AdnanCinisi/Pulse-Oximeter/AFE/Results/BodePlot.jpg

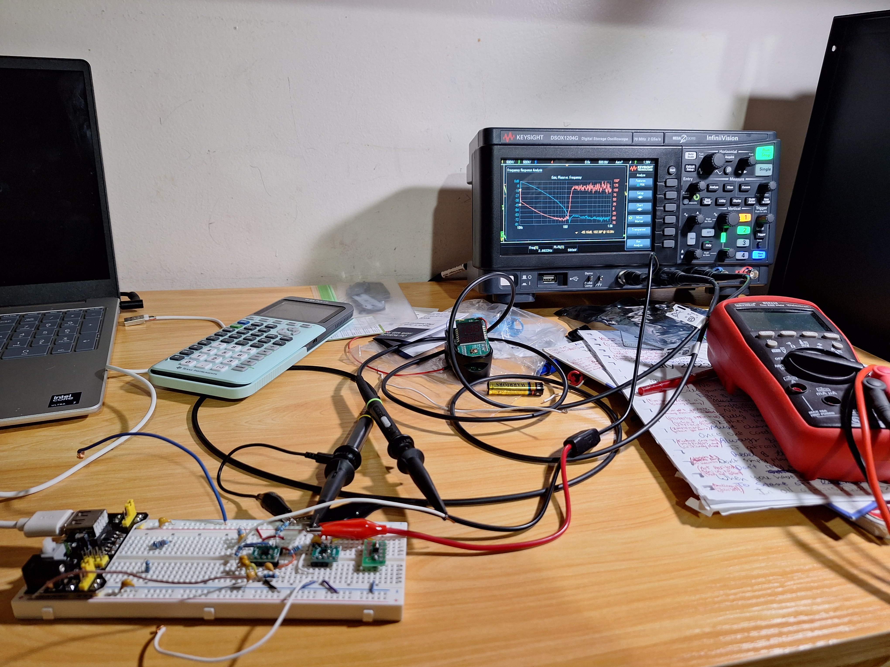
AFE/Results/BodePlot.jpg
