AdnanCinisi/Pulse-Oximeter/AFE/Results/PR_Capture.jpg

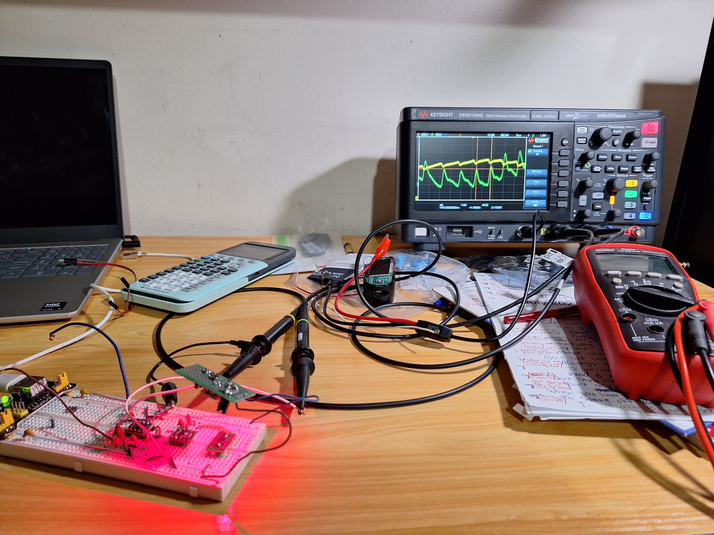
AFE/Results/PR_Capture.jpg
