AdnanCinisi/Pulse-Oximeter/README.md

# Pulse-Oximeter
Collection of Documentation created for designing portable IoT Pulse Oximeter

Master Spreadsheet: https://docs.google.com/spreadsheets/d/1wvMzt9Z9Bt-hhxMeCyEJHelC8ms1J6ctH8SdlQohNYU/edit?usp=sharing
