AdnanCinisi/Pulse-Oximeter/MCU/README.md

Source code, EVB prototype code, and other digital related items
