AdnanCinisi/Pulse-Oximeter/AltiumDocs/README.md

Altium Schematics & PCB files
Link to most recent Version: https://adnan-cinisi.365.altium.com/designs/D5FFC35A-2DEE-41BC-8201-609277D95F90
