AdnanCinisi/Pulse-Oximeter/AFE/README.md

Analog Front End Simulations & prototype Results
