AdnanCinisi/Pulse-Oximeter/Power/README.md

Simulations & other Docs for Power

Went with simple Arch: 
Batteries -> Boost -> LDO -> AFE+MCU+Screen
