AdnanCinisi/Pulse-Oximeter/AFE/SIMs/OPA320_Test.asc

U1: OPAx320-Q1
V1: voltage; SINE(2.5 2.5 1k)
V2: voltage; 6V
Named nets: Vsup, 0
.tran 0 5m 0 10u
