AdnanCinisi/Pulse-Oximeter/Power/TPS61040.asc

C1: cap; 4.7µ
C2: cap; 1µ
C3: cap; 20p
D1: diode
I1: current; PULSE(0 200m 1.5u .1u .1u 1)
L1: ind; 2.2µ
R1: res; 200k
R2: res; 380k
R3: res; 0
U2: TPS61040_TRANS
V1: voltage; PULSE(0 3 1us .01u .1u 1); Rser=10m
Named nets: 0, Vin, Vout
Vout = 3.6V
Check Excel for formulas
 
Gets loaded past ~100mA. Can this drive screen?
Reverse Recovery time of diode is faster than Tsw
AvgIout = 500mA
Pd = If * Vf = 500mA*390mV ~ 200mW
Do I need 30V diode?
.tran 0 200u 0 .1u
