AdnanCinisi/Pulse-Oximeter/AFE/SIMs/Sallen-Key LPF.asc

C1: cap; 1ľ
C2: cap; 3.9ľ
C3: cap; 1ľ
C4: cap; 1ľ
C5: cap; 1ľ
R1: res; 10k
R2: res; 200k
R3: res; 10k
R4: res; 13k
R5: res; 13k
R6: res; 1k
U1: OPAx320-Q1
U2: OPAx320-Q1
U3: OPAx320-Q1
V1: voltage; ""; AC 1
V2: voltage; SINE(0 1 .5)
V3: voltage; 1
V4: voltage; SINE(0 1 .5); AC 1
V5: voltage; SINE(0 1 .5)
V6: voltage; 2.5
V7: voltage; -2.5
V8: voltage; ""; AC 1
V9: voltage; SINE(0 1 .5)
Named nets: 0, 2v5, -2v5
IGNORE: Want Fc = 0.25Hz b/c 0.5Hz is min pulse freq
.ac dec 100 .01 100
.tran 0 5 0 1m
Even though my application has different supplies for OpAmp, 
with AC simulation, cannot set DC offset so Amp cannot have single supply
New Req: Fc = 10Hz
