AdnanCinisi/Pulse-Oximeter/AFE/SIMs/HPF.asc

C1: cap; 1ľ
C2: cap; 10ľ
C3: cap; 33n
C4: cap; 1ľ
C5: cap; 1ľ
R1: res; 820k
R2: res; 1Meg
R3: res; 240k
R4: res; 10k
R5: res; 10k
R6: res; 1k
R7: res; 82k
R8: res; 1k
R9: res; 410k
U1: OPAx320-Q1
U2: OPAx320-Q1
U3: OPAx320-Q1
V1: voltage; ""; AC 1
V2: voltage; SINE(0 1 .5)
V3: voltage; 1
V4: voltage; ""; AC 1
V5: voltage; SINE(0 1 .5)
V6: voltage; 2.5
V7: voltage; -2.5
V8: voltage; 1.6
V9: voltage; SINE(0 1 .5)
V10: voltage; 1
V11: voltage; ""; AC 1
Named nets: 0, 2v5, -2v5
IGNORE: Want Fc = 0.2Hz b/c 0.5Hz is min pulse freq
.ac dec 500 .001 500
.tran 0 5 0 1m
Even though my application has different supplies for OpAmp, 
with AC simulation, cannot set DC offset so Amp cannot have single supply
New Req: Fc = 10Hz
Choosen Topology because combines gain & offset into 1 amp!
