AdnanCinisi/Pulse-Oximeter/AFE/SIMs/AFE.asc

C1: cap; 1nF; Rser=50m
C2: cap; 1µ
C3: cap; 10µ
C4: cap; 5p
C5: cap; 1µ
C6: cap; 27n; Rser=50m
C7: cap; 1µ
C8: cap; 5p
C9: cap; 1n
C10: cap; 5p
C11: cap; 1n
C12: cap; 5p
Cj: cap; 70p
Noise: current; SINE(0 2u 60)
PhotoDiode_AC: current; SINE(0 {Pulse_max} 2)
PhotoDiode_DC: current; {DC}
R1: res; {R_FB}; tol=1
R4: res; 82k
R5: res; 13k
R6: res; 100k
R7: res; 3Meg
R8: res; 3Meg
R9: res; 13k
R10: res; 100k
R13: res; 100k
R14: res; 100k
R15: res; 0.1k
R16: res; 1k
Rfb: res; 510k
U1: OPAx320-Q1
U2: OPAx320-Q1
U4: OPAx320-Q1
V1: voltage; 3.3
Named nets: 0, 3V3, out_TIA, Vin-, DC_Input, HPF_Vbias, AC_Input
.tran 0 10m 0 1us startup
.param R_FB=100k
- Typ. Ira = 55uA, but according to sr calc, signal is 1uA - 5uA 
with red's 1mW/cm2. Will take Ipd_max = 60uA for cushion
  > Did quick short ckt Exp & good Ipd_max is 30uA
- Selecting R_FB: 3.2V-0.1V/30uA ~ 100k
- Typ. rise & fall time = 100ns
- Will use diode Cap at Vr = Vbias ~0V -> 70pF. B/c diode
isn't reverse biased (In- = In+) voltage isn't a factor for Ipd
No need to bias IN+. Amp will saturate but
Overload Revovery Time is ~100ns!
.param DC=15u
.param Pulse_min=DC/500
.ac dec 100 .1 10Meg
.dc PhotoDiode_DC 0 40u 0.5u
Want Fc around 10Hz b/c 5Hz is max pulse freq
Use Sallen Key with equal values- Fc ~ 7.7Hz
5Hz is attenuated by ~15%... Need to have SW to counteract
HPF Fc = 0.2 since min pulse freq = 0.5Hz
LPF Fc = 11.5Hz
Inverting BPF fine because only care for Pk-Pk
Gain of 510/82 ~ 6.2 and DC offset = 1.6
.param Pulse_max=DC/5
Perfusion Index: 0.2% - 20%
OPA320 input bias current max of 50pA so 
input R = 0.1V/50pA = 2Gohm
V+ pins of Amps should have 0.1uF cap
Resistor Tolerances: 1%
TIA Feedback Cap & Active filter Caps: C0G
All other caps: X7R
Don't need LPF to get DC signal b/c can implement LPF/Averaging in SW. 
Active filter also serves as a buffer between TIA output & ADC
BW ~ 1500Hz, don't need fast response 
since signals of interest are < 10Hz
 
100k Rfb gives max Ipd of 31uA
.fra tstart=0 dtmax=1u
SAR ADC samples for ~100ns.
Typ values from STM32WB55 datasheet
Battery ADC input circuit
Rser = 1k, Cshu = 1nF
Design Choices
- I could move AC coupling cap to beginning of LPF & make band pass
but I need gain & SallenKey architecture doesn't play well with too 
much gain. For now, will take cost of additional amp but may need 
more elegant active filter arch for future
