AdnanCinisi/Pulse-Oximeter/AFE/SIMs/LEDs.asc

D1: diode
D2: diode
D3: diode
D4: diode
D5: diode
R1: res; 62
R2: res; 91
U1: NMOS_SSM3K16FV
U2: NMOS_SSM3K16FV
V1: voltage; 3.3
Named nets: 0, 3v3
.tran 0 1 0 1m
