AdnanCinisi/Pulse-Oximeter/AFE/Results/IR_PulseOxi1.png

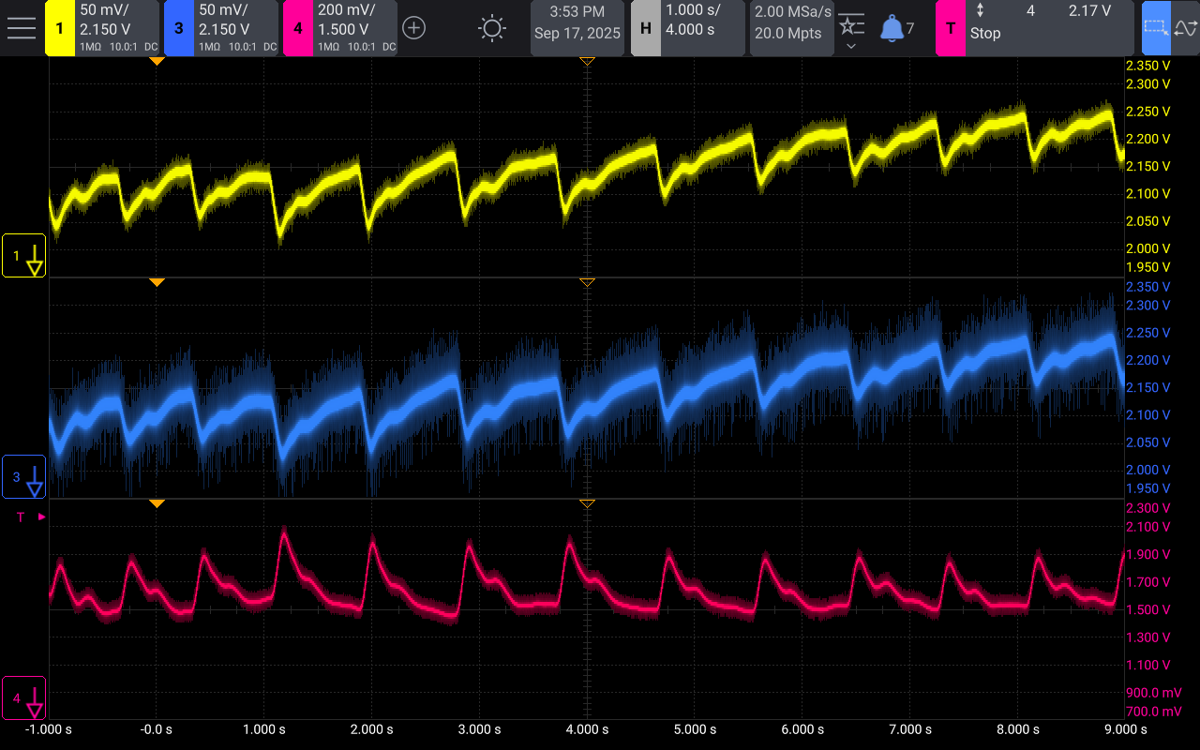
AFE/Results/IR_PulseOxi1.png
