AdnanCinisi/Pulse-Oximeter/AFE/Results/IR_PulseOxi.png

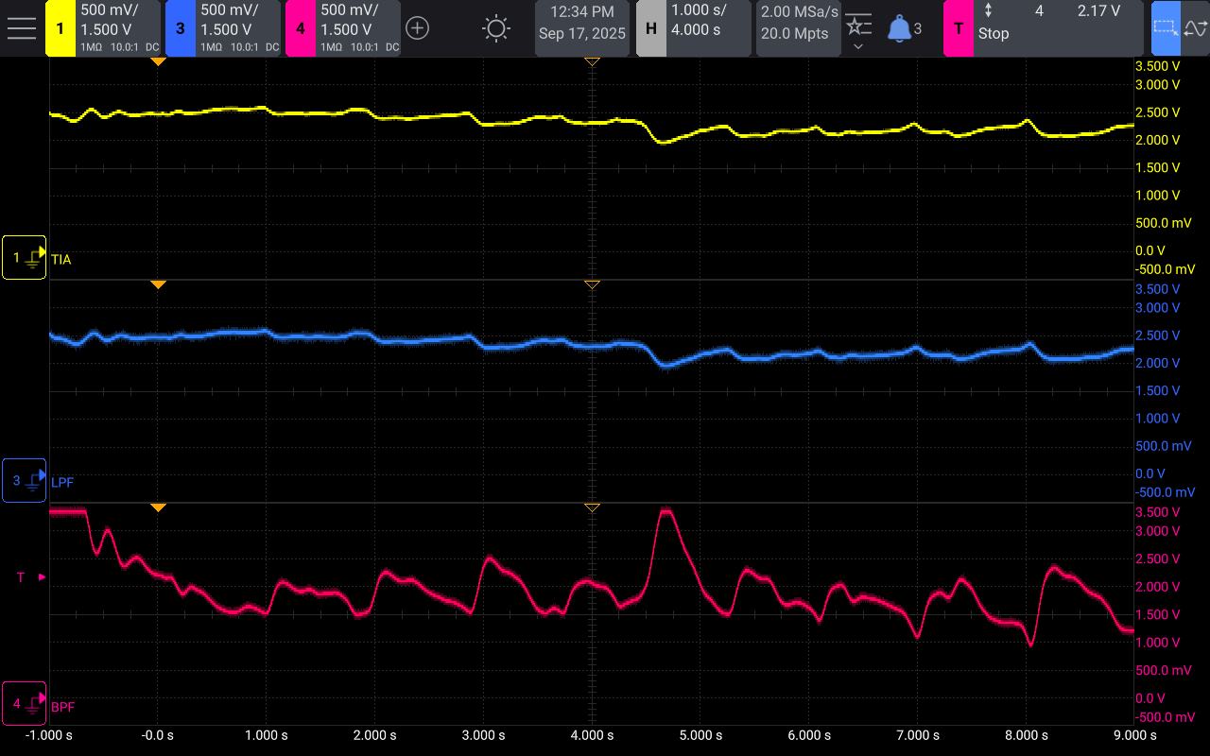
AFE/Results/IR_PulseOxi.png
