AdnanCinisi/Pulse-Oximeter/AFE/Results/Red_PulseOxi.png

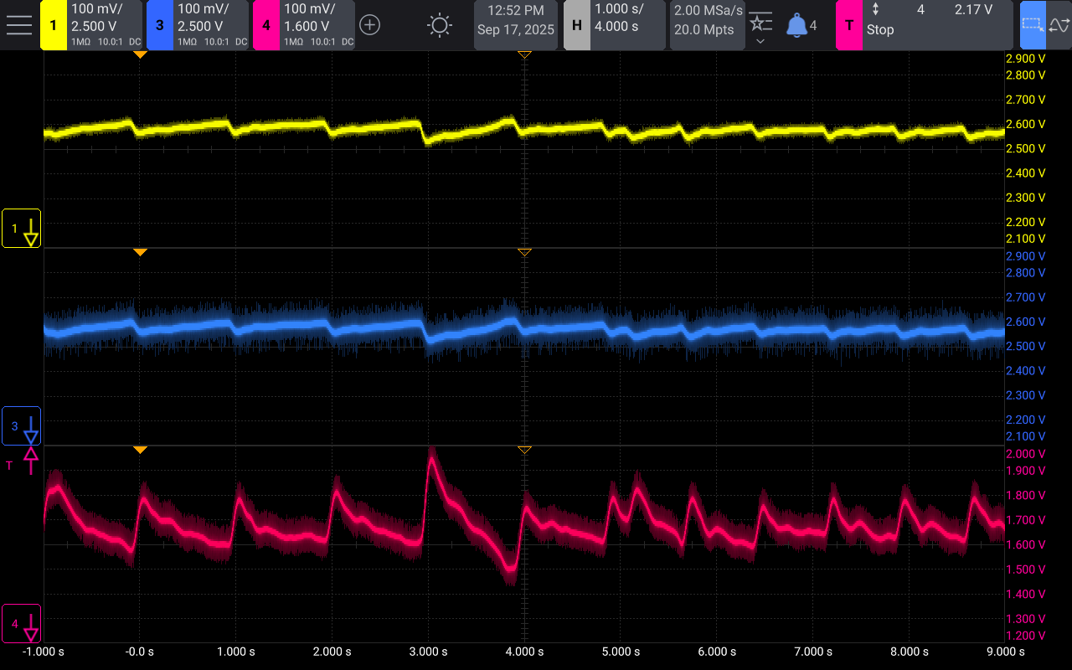
AFE/Results/Red_PulseOxi.png
