AdnanCinisi/Pulse-Oximeter/MCU/EVB_IOT_PulseOxi__AFE_with_low_BW/Core/Src/main.c

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
/* Includes ------------------------------------------------------------------*/
#include "main.h"


COM_InitTypeDef BspCOMInit;
static uint32_t delay = 250;

void SystemClock_Config(void);
void PeriphCommonClock_Config(void);
static void MX_GPIO_Init(void);
/**
  * @brief  The application entry point.
  * @retval int
  */
int main(void)
{

  /* MCU Configuration--------------------------------------------------------*/

  /* Reset of all peripherals, Initializes the Flash interface and the Systick. */
  HAL_Init();

  /* Configure the system clock */
  SystemClock_Config();

  /* Configure the peripherals common clocks */
  PeriphCommonClock_Config();

  /* Initialize all configured peripherals */
  MX_GPIO_Init();
  /* Initialize leds */
  BSP_LED_Init(LED_BLUE);
  BSP_LED_Init(LED_GREEN);
  BSP_LED_Init(LED_RED);

  /* Initialize USER push-button, will be used to trigger an interrupt each time it's pressed.*/
  BSP_PB_Init(BUTTON_SW1, BUTTON_MODE_EXTI);
  BSP_PB_Init(BUTTON_SW2, BUTTON_MODE_EXTI);
  BSP_PB_Init(BUTTON_SW3, BUTTON_MODE_EXTI);

  /* Initialize COM1 port (115200, 8 bits (7-bit data + 1 stop bit), no parity */
  BspCOMInit.BaudRate   = 115200;
  BspCOMInit.WordLength = COM_WORDLENGTH_8B;
  BspCOMInit.StopBits   = COM_STOPBITS_1;
  BspCOMInit.Parity     = COM_PARITY_NONE;
  BspCOMInit.HwFlowCtl  = COM_HWCONTROL_NONE;
  if (BSP_COM_Init(COM1, &BspCOMInit) != BSP_ERROR_NONE)
  {
    Error_Handler();
  }

  /* USER CODE BEGIN BSP */

  /* -- Sample board code to send message over COM1 port ---- */
  printf("Welcome to STM32 world !\n\r");

  /* -- Sample board code to switch on leds ---- */
  BSP_LED_On(LED_BLUE);
  BSP_LED_On(LED_GREEN);
  BSP_LED_On(LED_RED);

  /* USER CODE END BSP */

  /* Infinite loop */
  /* USER CODE BEGIN WHILE */
  while (1)
  {

    /* -- Sample board code for User push-button in interrupt mode ---- */
    BSP_LED_Toggle(LED_BLUE);
    HAL_Delay(delay);

    BSP_LED_Toggle(LED_GREEN);
    HAL_Delay(delay);

    BSP_LED_Toggle(LED_RED);
    HAL_Delay(delay);

    /* USER CODE END WHILE */

    /* USER CODE BEGIN 3 */
  }
  /* USER CODE END 3 */
}

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
/**
  * @brief EXTI line detection callback.
  * @param GPIO_Pin: Specifies the pins connected EXTI line
  * @retval None
  */
void HAL_GPIO_EXTI_Callback(uint16_t GPIO_Pin)
{
  switch(GPIO_Pin)
  {
    case BUTTON_SW1_PIN:
      /* Change the period to 100 ms */
      delay = 100;
      break;
    case BUTTON_SW2_PIN:
      /* Change the period to 500 ms */
      delay = 500;
      break;
    case BUTTON_SW3_PIN:
      /* Change the period to 1000 ms */
      delay = 1000;
      break;
    default:
      break;
  }
}

/**
  * @brief  This function is executed in case of error occurrence.
  * @retval None
  */
void Error_Handler(void)
{
  /* USER CODE BEGIN Error_Handler_Debug */
  /* User can add his own implementation to report the HAL error return state */
  __disable_irq();
  while (1)
  {
  }
  /* USER CODE END Error_Handler_Debug */
}
#ifdef USE_FULL_ASSERT
/**
  * @brief  Reports the name of the source file and the source line number
  *         where the assert_param error has occurred.
  * @param  file: pointer to the source file name
  * @param  line: assert_param error line source number
  * @retval None
  */
void assert_failed(uint8_t *file, uint32_t line)
{
  /* USER CODE BEGIN 6 */
  /* User can add his own implementation to report the file name and line number,
     ex: printf("Wrong parameters value: file %s on line %d\r\n", file, line) */
  /* USER CODE END 6 */
}
#endif /* USE_FULL_ASSERT */
