AdnanCinisi/Pulse-Oximeter/MCU/EVB_IOT_PulseOxi__AFE_with_low_BW/EVB_IOT_PulseOxi.ioc

Mcu.UserName=STM32WB55RGVx
PA11.GPIO_Label=USB_DM
PA11.Signal=USB_DM
PA12.GPIO_Label=USB_DP
PA12.Signal=USB_DP
PA13.GPIO_Label=JTMS
PA13.Signal=SYS_JTMS-SWDIO
PA14.GPIO_Label=JTCK
PA14.Signal=SYS_JTCK-SWCLK
PB0.Signal=GPIO_Output
PB1.Signal=GPIO_Output
PB3.GPIO_Label=JTDO
PB3.Signal=SYS_JTDO-SWO
PB5.Signal=GPIO_Output
PB6.Signal=USART1_TX
PB7.Signal=USART1_RX
PC13.GPIO_Label=SYS_WKUP2
PC13.Signal=SYS_WKUP2
PC14-OSC32_IN.GPIO_Label=RCC_OSC32_IN
PC14-OSC32_IN.Signal=RCC_OSC32_IN
PC15-OSC32_OUT.GPIO_Label=RCC_OSC32_OUT
PC15-OSC32_OUT.Signal=RCC_OSC32_OUT
PC4.Signal=GPIO_Input
PD0.Signal=GPIO_Input
PD1.Signal=GPIO_Input
