AdnanCinisi/Pulse-Oximeter/(notices)

Notices in the files:
MCU/EVB_IOT_PulseOxi__AFE_with_low_BW/Core/Src/main.c:
Copyright (c) 2025 STMicroelectronics.
All rights reserved.
This software is licensed under terms that can be found in the LICENSE file
